kingovchouffe/Mini-DSP/Test board/Test board.pdf

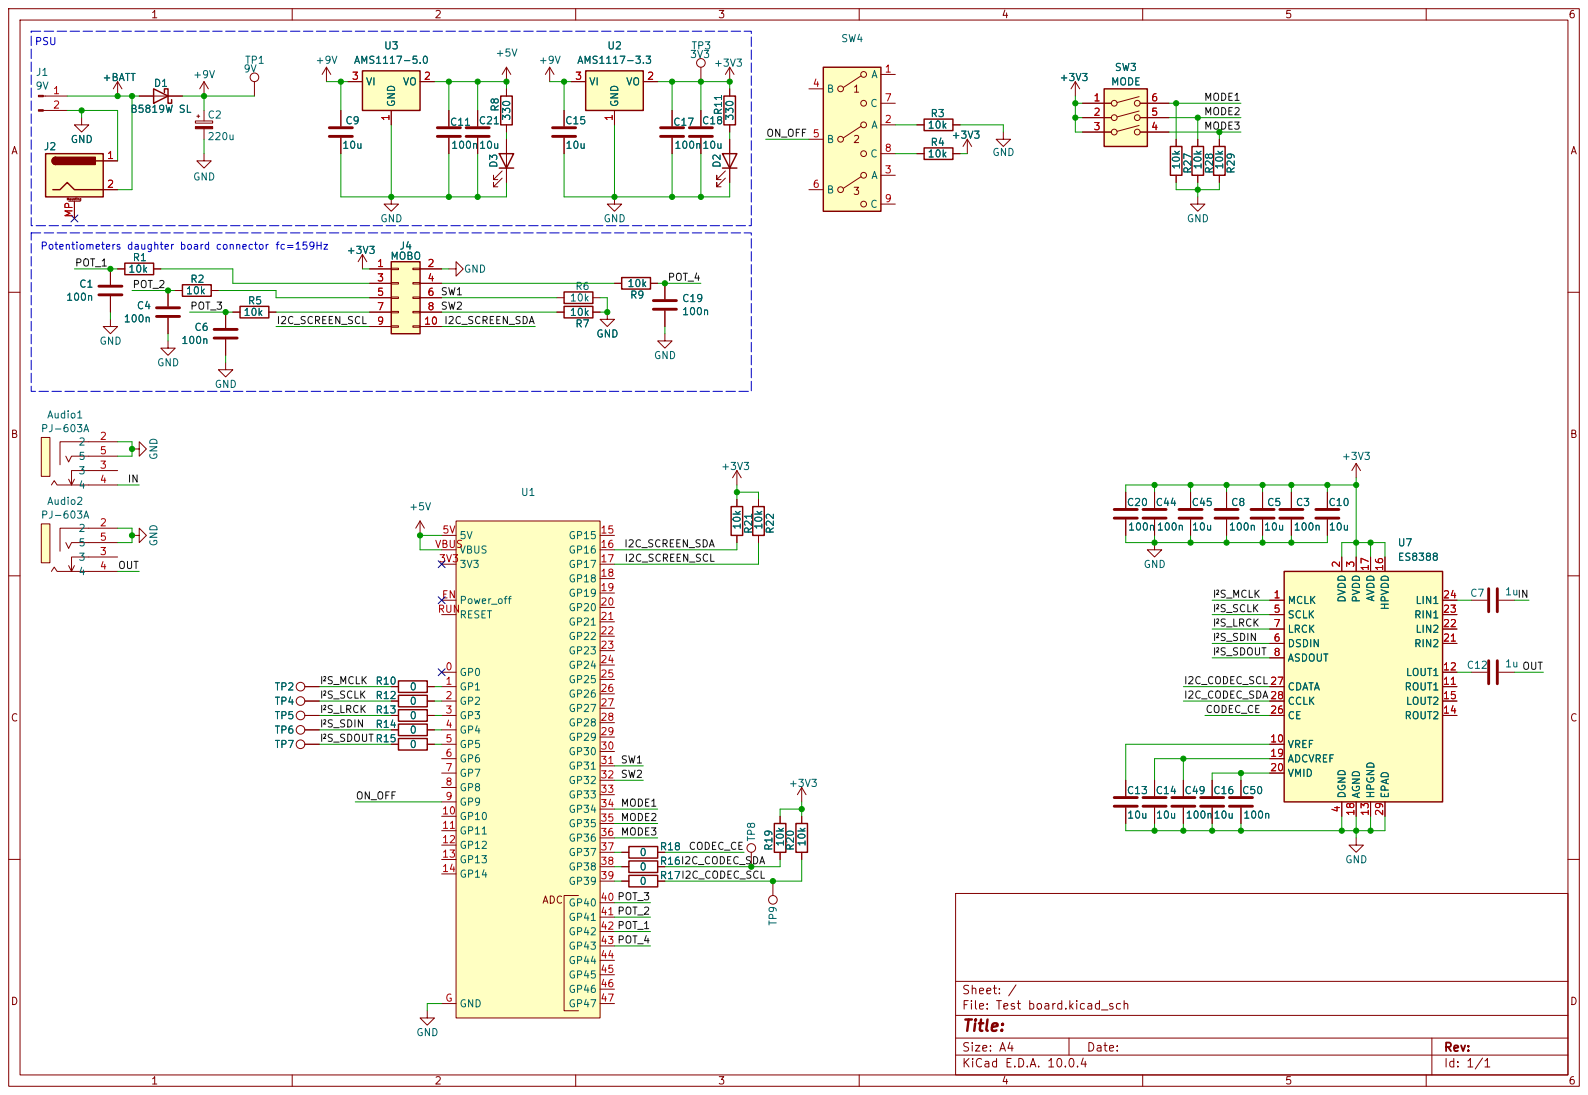
[picture p1: page 1]

Size: A4 | Rev:
KiCad E.D.A. 10.0.4 | Id: 1/1
