kingovchouffe/Mini-DSP/HW/raspi-uhat-codec/raspi-uhat-codec.kicad_pcb

## KiCad design HW/raspi-uhat-codec/raspi-uhat-codec.kicad_pcb (2026-11-07)

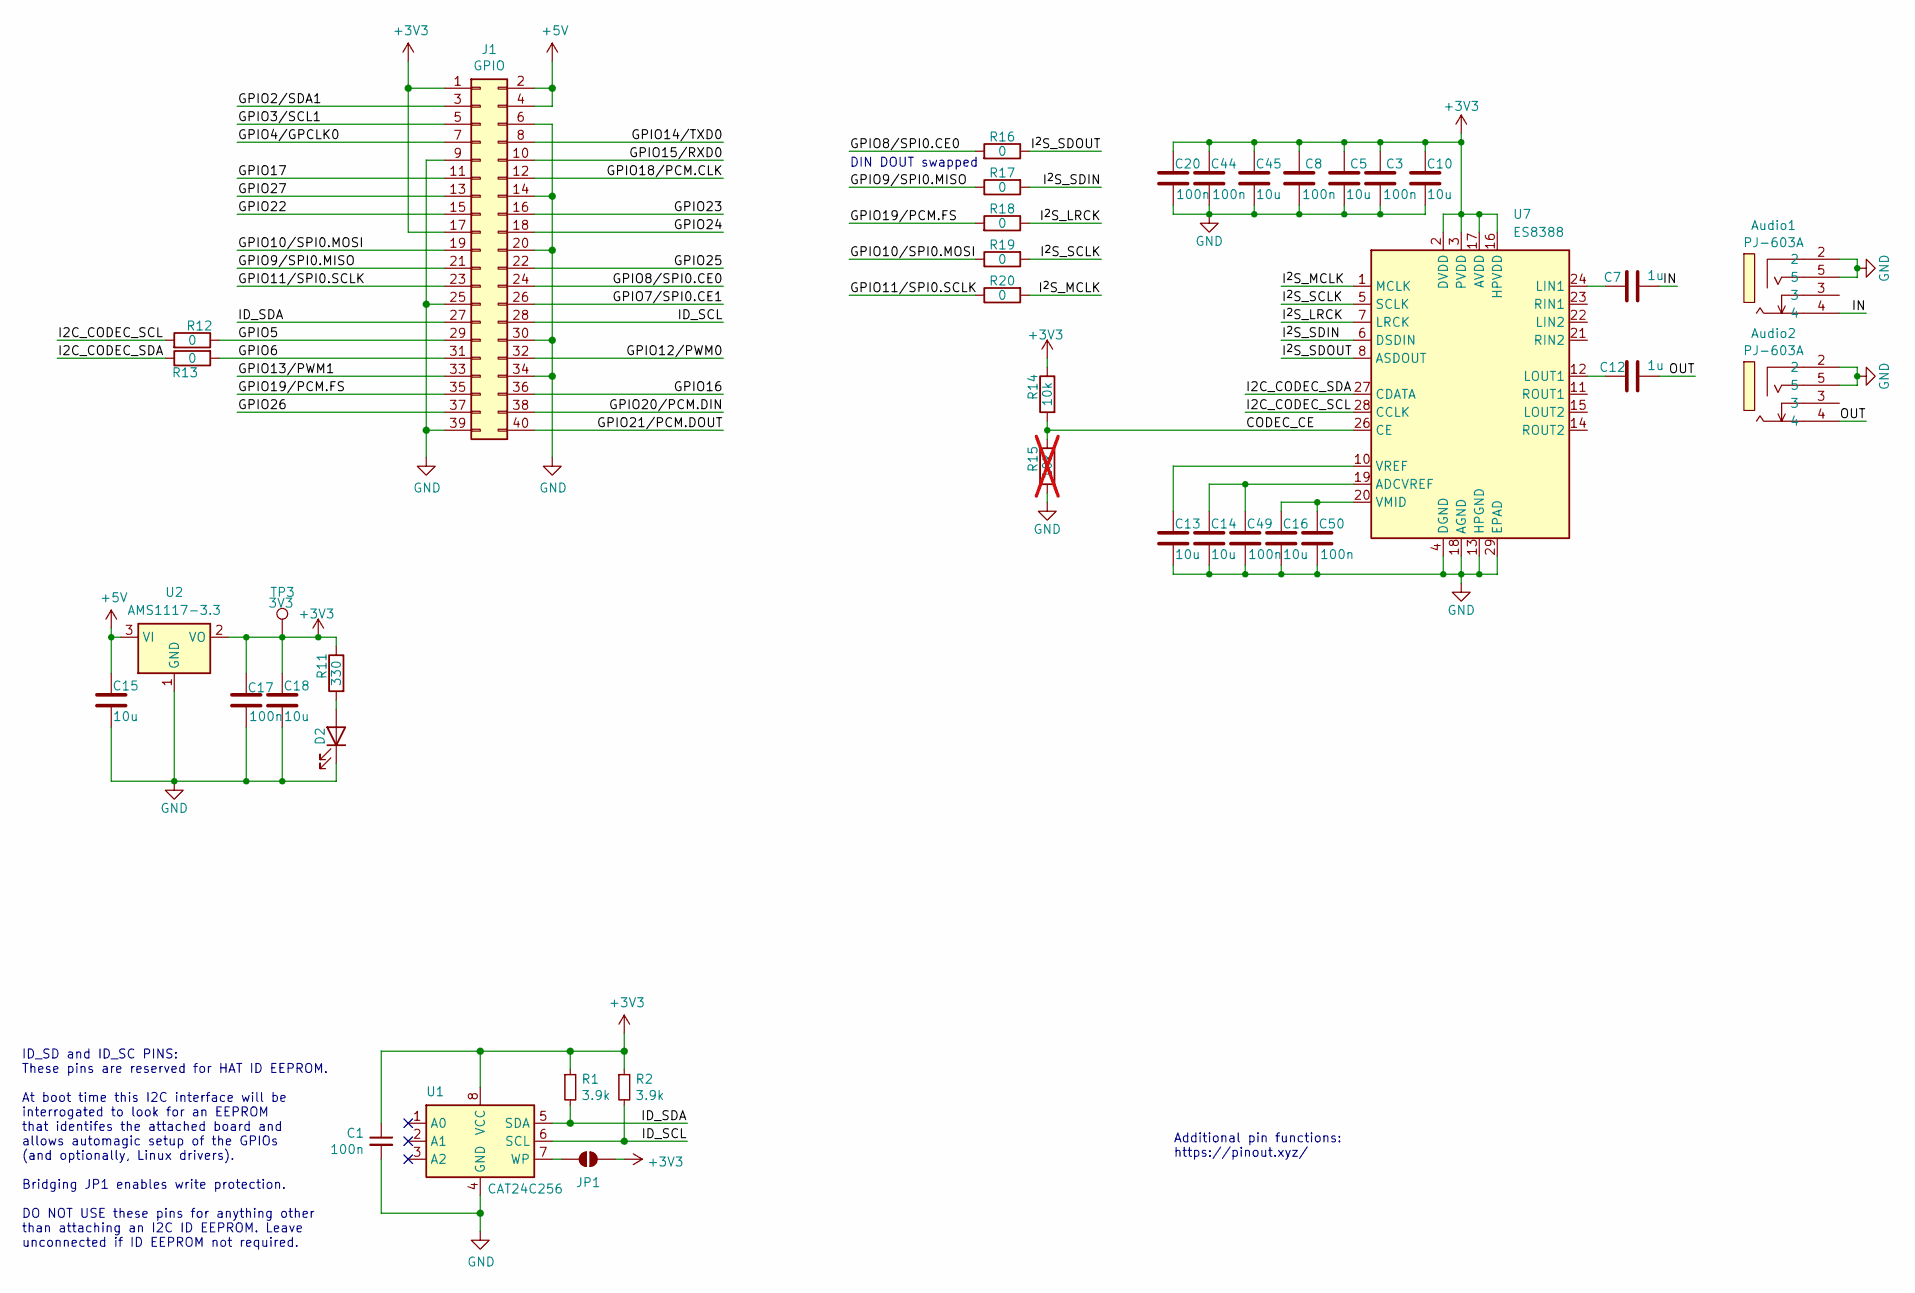
[picture p2: schematic raspi-uhat-codec.kicad_sch]

Parts:
Audio1, Audio2: PJ-603A; AUDIO-TH_PJ-603A_1; LCSC Part C309273
C1, C3, C8, C17, C20, C44, C49, C50: 100n; C_0603_1608Metric
C5, C10, C13, C14, C15, C16, C18, C45: 10u; C_0603_1608Metric
C7, C12: 1u; C_0805_2012Metric
D2: CTL1; LED_0805_2012Metric
J1: GPIO; PinSocket_2x20_P2.54mm_Vertical
JP1: ID_WP; SolderJumper-2_P1.3mm_Open_TrianglePad1.0x1.5mm
R1, R2: 3.9k; R_0603_1608Metric
R11: 330; R_0603_1608Metric
R12, R13, R16, R17, R18, R19, R20: 0; R_0603_1608Metric
R14: 10k; R_0603_1608Metric
R15: 10k; R_0603_1608Metric; not fitted
TP3: 3V3; TestPoint_Pad_D1.0mm
U1: CAT24C256; SOIC-8_3.9x4.9mm_P1.27mm
U2: AMS1117-3.3; SOT-223-3_TabPin2
U7: ES8388; QFN-28-1EP_4x4mm_P0.45mm_EP2.6x2.6mm

Connections:
+3V3: C1.1, C3.1, C5.1, C8.1, C10.1, C17.1, C18.1, C20.1, C44.1, C45.1, J1.1, J1.17, JP1.2 (B), R1.1, R2.1, R11.1, R14.1, TP3.1 (1_1), U1.8 (VCC), U2.2 (VO), U7.2 (DVDD), U7.3 (PVDD), U7.16 (HPVDD), U7.17 (AVDD)
+5V: C15.1, J1.2, J1.4, U2.3 (VI)
/CODEC_CE: R14.2, R15.1, U7.26 (CE)
/GPIO2/SDA1: J1.3
/GPIO3/SCL1: J1.5
/GPIO4/GPCLK0: J1.7
/GPIO5: J1.29, R12.1
/GPIO6: J1.31, R13.2
/GPIO7/SPI0.CE1: J1.26
/GPIO8/SPI0.CE0: J1.24, R16.2
/GPIO9/SPI0.MISO: J1.21, R17.1
/GPIO10/SPI0.MOSI: J1.19, R19.1
/GPIO11/SPI0.SCLK: J1.23, R20.1
/GPIO12/PWM0: J1.32
/GPIO13/PWM1: J1.33
/GPIO14/TXD0: J1.8
/GPIO15/RXD0: J1.10
/GPIO16: J1.36
/GPIO17: J1.11
/GPIO18/PCM.CLK: J1.12
/GPIO19/PCM.FS: J1.35, R18.2
/GPIO20/PCM.DIN: J1.38
/GPIO21/PCM.DOUT: J1.40
/GPIO22: J1.15
/GPIO23: J1.16
/GPIO24: J1.18
/GPIO25: J1.22
/GPIO26: J1.37
/GPIO27: J1.13
/I2C_CODEC_SCL: R12.2, U7.28 (CCLK)
/I2C_CODEC_SDA: R13.1, U7.27 (CDATA)
/ID_SCL: J1.28, R2.2, U1.6 (SCL)
/ID_SDA: J1.27, R1.2, U1.5 (SDA)
/IN: Audio1.4, C7.2
/I^{2}S_LRCK: R18.1, U7.7 (LRCK)
/I^{2}S_MCLK: R20.2, U7.1 (MCLK)
/I^{2}S_SCLK: R19.2, U7.5 (SCLK)
/I^{2}S_SDIN: R17.2, U7.6 (DSDIN)
/I^{2}S_SDOUT: R16.1, U7.8 (ASDOUT)
/OUT: Audio2.4, C12.2
GND: Audio1.2, Audio1.5, Audio2.2, Audio2.5, C1.2, C3.2, C5.2, C8.2, C10.2, C13.2, C14.2, C15.2, C16.2, C17.2, C18.2, C20.2, C44.2, C45.2, C49.2, C50.2, D2.1 (K), J1.6, J1.9, J1.14, J1.20, J1.25, J1.30, J1.34, J1.39, R15.2, U1.4 (GND), U2.1 (GND), U7.4 (DGND), U7.13 (HPGND), U7.18 (AGND), U7.29 (EPAD)
unnamed: D2.2 (A), R11.2
unnamed: JP1.1 (A), U1.7 (WP)
unnamed: C14.1, C49.1, U7.19 (ADCVREF)
unnamed: C7.1, U7.24 (LIN1)
unnamed: C12.1, U7.12 (LOUT1)
unnamed: C16.1, C50.1, U7.20 (VMID)
unnamed: C13.1, U7.10 (VREF)

Notes on the sheet:
ID_SD and ID_SC PINS: These pins are reserved for HAT ID EEPROM. At boot time this I2C interface will be interrogated to look for an EEPROM that identifes the attached board and allows automagic setup of the GPIOs (and optionally, Linux drivers). Bridging JP1 enables write protection. DO NOT USE th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
DIN DOUT swapped
Additional pin functions: https://pinout.xyz/

Board: 2 copper layers, 43 parts (1 on the bottom side), 29 nets, no tracks yet.

Other parts of the board:
MH1, MH2, MH3, MH4: MountingHole_2.7mm_M2.5
