kingovchouffe/Mini-DSP/HW/Main/Mini-DSP.kicad_pcb

## KiCad design HW/Main/Mini-DSP.kicad_pcb (2026-11-07)

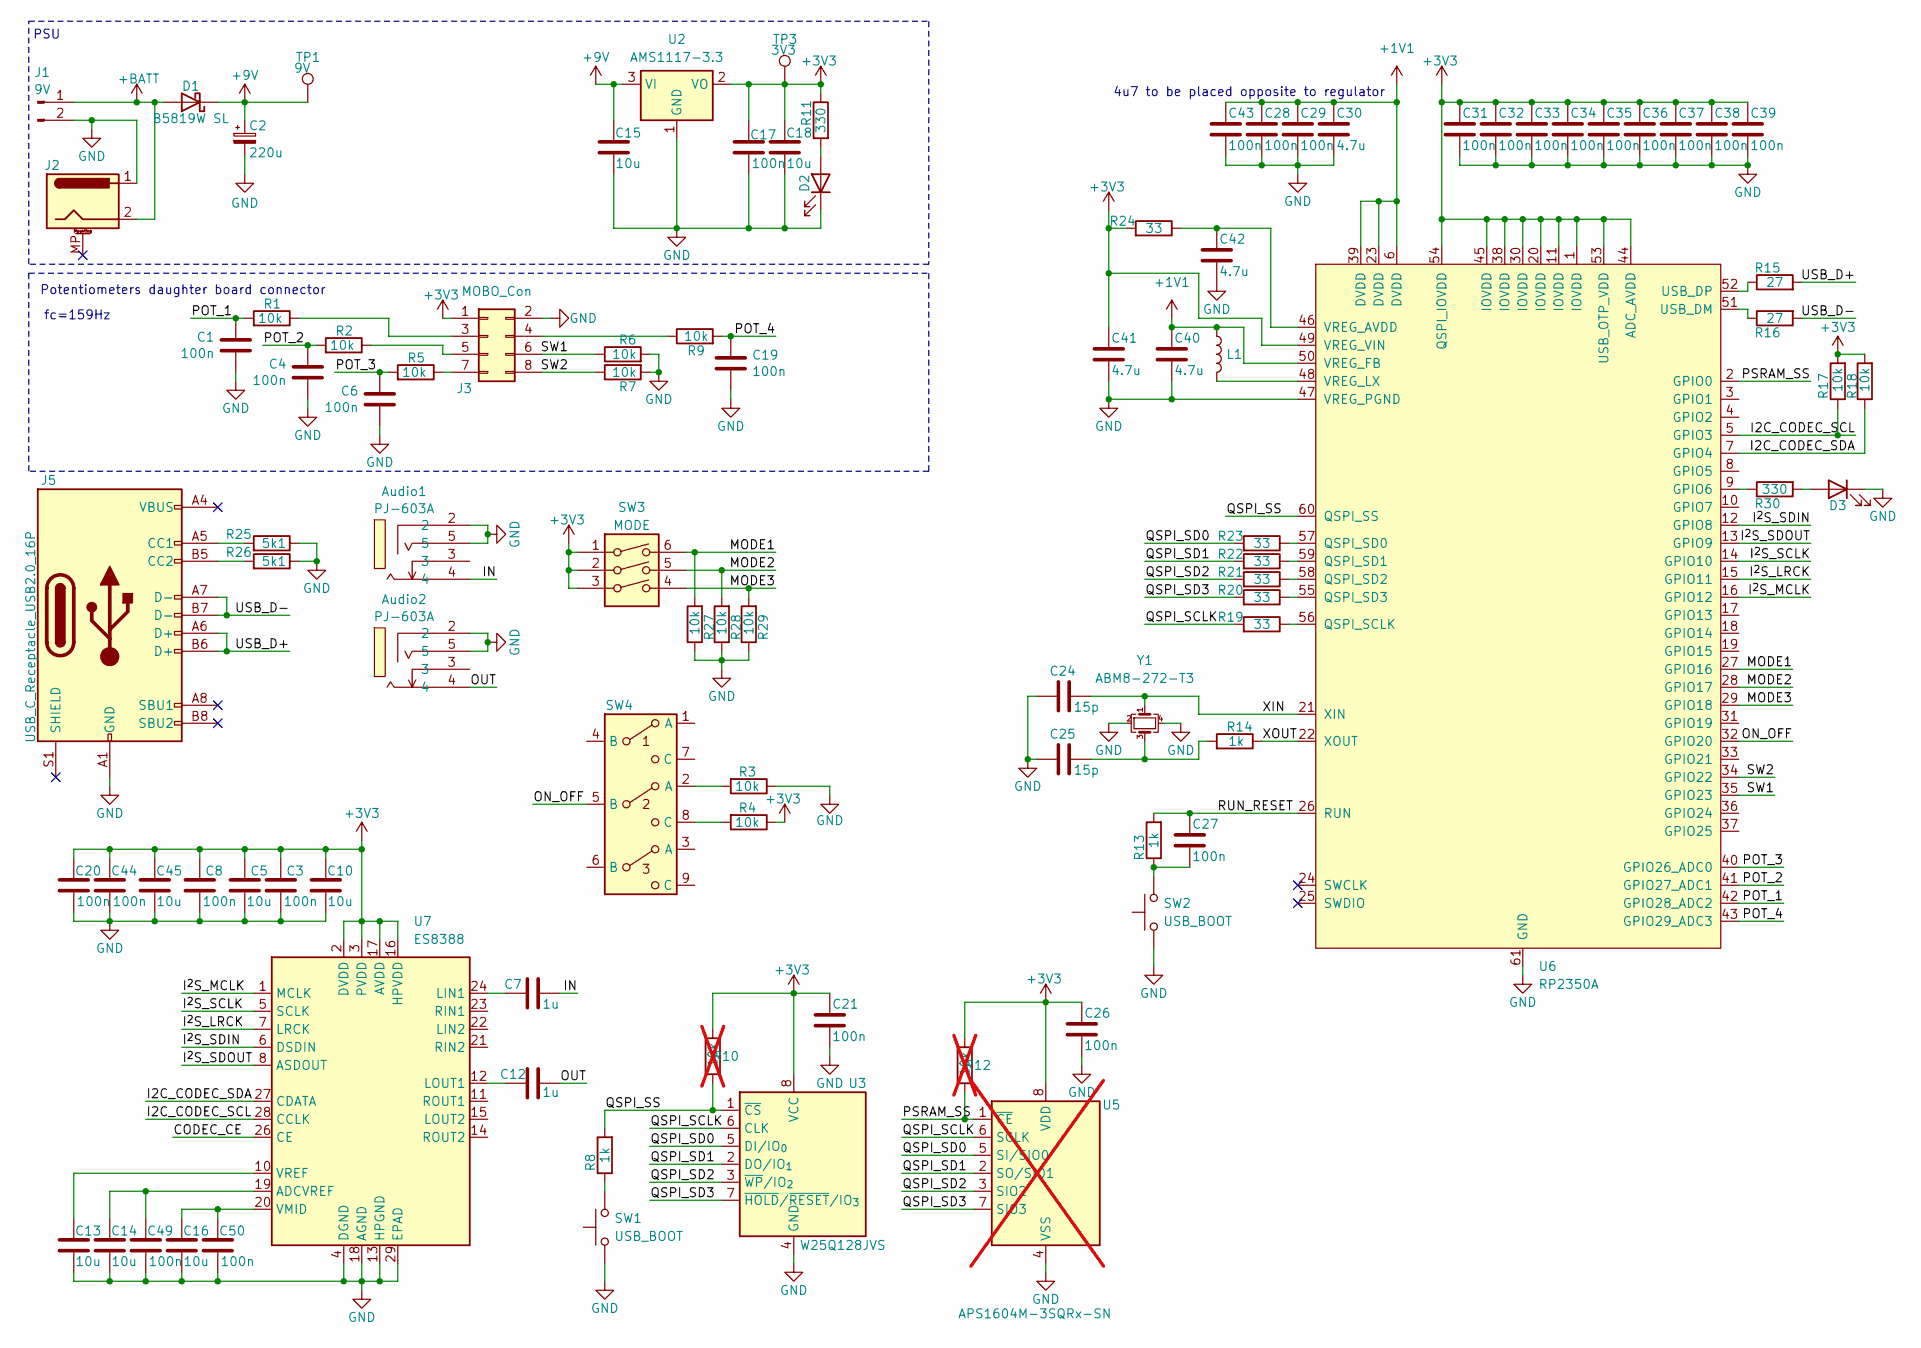
[picture p3: schematic Mini-DSP.kicad_sch]

Parts:
Audio1, Audio2: PJ-603A; AUDIO-TH_PJ-603A_1; LCSC Part C309273
C1, C3, C4, C6, C8, C17, C19, C20, C21, C26, C27, C28, C29, C31, C32, C33, C34, C35, C36, C37, C38, C39, C43, C44, C49, C50: 100n; C_0402_1005Metric
C2: 220u; CP_Elec_6.3x7.7
C5, C10, C13, C14, C15, C16, C18, C45: 10u; C_0603_1608Metric
C7, C12: 1u; C_0805_2012Metric
C24, C25: 15p; C_0402_1005Metric
C30, C40, C41, C42: 4.7u; C_0402_1005Metric
D1: B5819W SL; D_SOD-323; JLCPCB Part C8598
D2, D3: CTL1; LED_0603_1608Metric
J1: 9V; PinSocket_1x02_P2.54mm_Vertical
J2: Barrel_Jack_MountingPin; BarrelJack_Horizontal
J3: MOBO_Con; PinSocket_2x04_P2.54mm_Vertical
J5: USB_C_Receptacle_USB2.0_16P; USB_C_Receptacle_HCTL_HC-TYPE-C-16P-01A
L1: AOTA-B201610S3R3-101-T; L_Murata_DFE201610P
R1, R2, R3, R4, R5, R6, R7, R9, R17, R18, R27, R28, R29: 10k; R_0402_1005Metric
R8, R13, R14: 1k; R_0402_1005Metric
R10, R12: 10k; R_0402_1005Metric; not fitted
R11, R30: 330; R_0402_1005Metric
R15, R16: 27; R_0402_1005Metric
R19, R20, R21, R22, R23, R24: 33; R_0402_1005Metric
R25, R26: 5k1; R_0402_1005Metric
SW1, SW2: USB_BOOT; SW_SPST_TS-1088-xR020
SW3: MODE; SW_DIP_SPSTx03_Slide_KingTek_DSHP03TS_W7.62mm_P1.27mm
SW4: 3PDT_LED
TP1: 9V; TestPoint_Pad_D1.0mm
TP3: 3V3; TestPoint_Pad_D1.0mm
U2: AMS1117-3.3; SOT-223-3_TabPin2
U3: W25Q128JVS; SOIC-8_5.3x5.3mm_P1.27mm
U5: APS1604M-3SQRx-SN; SOIC-8_3.9x4.9mm_P1.27mm; not fitted
U6: RP2350A; QFN-60-1EP_7x7mm_P0.4mm_EP3.4x3.4mm_ThermalVias
U7: ES8388; QFN-28-1EP_4x4mm_P0.45mm_EP2.6x2.6mm
Y1: ABM8-272-T3; Crystal_SMD_3225-4Pin_3.2x2.5mm

Connections:
+1V1: C28.1, C29.1, C30.1, C40.1, C43.1, L1.1, U6.6 (DVDD), U6.23 (DVDD), U6.39 (DVDD), U6.50 (VREG_FB)
+3V3: C3.1, C5.1, C8.1, C10.1, C17.1, C18.1, C20.1, C21.1, C26.1, C31.1, C32.1, C33.1, C34.1, C35.1, C36.1, C37.1, C38.1, C39.1, C41.1, C44.1, C45.1, J3.1, R4.1, R10.2, R11.1, R12.2, R17.2, R18.2, R24.2, SW3.1, SW3.2, SW3.3, TP3.1 (1_1), U2.2 (VO), U3.8 (VCC), U5.8 (VDD), U6.1 (IOVDD), U6.11 (IOVDD), U6.20 (IOVDD), U6.30 (IOVDD), U6.38 (IOVDD), U6.44 (ADC_AVDD), U6.45 (IOVDD), U6.49 (VREG_VIN), U6.53 (USB_OTP_VDD), U6.54 (QSPI_IOVDD), U7.2 (DVDD), U7.3 (PVDD), U7.16 (HPVDD), U7.17 (AVDD)
+9V: C2.1, C15.1, D1.1 (K), TP1.1 (1_1), U2.3 (VI)
+BATT: D1.2 (A), J1.1, J2.2
/CODEC_CE: U7.26 (CE)
/I2C_CODEC_SCL: R17.1, U6.5 (GPIO3), U7.28 (CCLK)
/I2C_CODEC_SDA: R18.1, U6.7 (GPIO4), U7.27 (CDATA)
/IN: Audio1.4, C7.2
/I^{2}S_LRCK: U6.15 (GPIO11), U7.7 (LRCK)
/I^{2}S_MCLK: U6.16 (GPIO12), U7.1 (MCLK)
/I^{2}S_SCLK: U6.14 (GPIO10), U7.5 (SCLK)
/I^{2}S_SDIN: U6.12 (GPIO8), U7.6 (DSDIN)
/I^{2}S_SDOUT: U6.13 (GPIO9), U7.8 (ASDOUT)
/MODE1: R27.2, SW3.6, U6.27 (GPIO16)
/MODE2: R28.2, SW3.5, U6.28 (GPIO17)
/MODE3: R29.2, SW3.4, U6.29 (GPIO18)
/ON_OFF: SW4.5 (B), U6.32 (GPIO20)
/OUT: Audio2.4, C12.2
/POT_1: C1.1, R1.2, U6.42 (GPIO28_ADC2)
/POT_2: C4.1, R2.2, U6.41 (GPIO27_ADC1)
/POT_3: C6.1, R5.2, U6.40 (GPIO26_ADC0)
/POT_4: C19.1, R9.2, U6.43 (GPIO29_ADC3)
/PSRAM_SS: R12.1, U5.1 (~CE), U6.2 (GPIO0)
/QSPI_SCLK: R19.2, U3.6 (CLK), U5.6 (SCLK)
/QSPI_SD0: R23.2, U3.5 (DI/IO_{0}), U5.5 (SI/SIO0)
/QSPI_SD1: R22.2, U3.2 (DO/IO_{1}), U5.2 (SO/SIO1)
/QSPI_SD2: R21.2, U3.3 (~WP/IO_{2}), U5.3 (SIO2)
/QSPI_SD3: R20.2, U3.7 (~HOLD/~RESET/IO_{3}), U5.7 (SIO3)
/QSPI_SS: R8.2, R10.1, U3.1 (~CS), U6.60 (QSPI_SS)
/RUN_RESET: C27.1, R13.2, U6.26 (RUN)
/SW1: J3.6, R6.1, U6.35 (GPIO23)
/SW2: J3.8, R7.1, U6.34 (GPIO22)
/USB_D+: J5.A6 (D+), J5.B6 (D+), R15.2
/USB_D-: J5.A7 (D-), J5.B7 (D-), R16.2
/XIN: C24.2, U6.21 (XIN), Y1.1
/XOUT: R14.1, U6.22 (XOUT)
GND: Audio1.2, Audio1.5, Audio2.2, Audio2.5, C1.2, C2.2, C3.2, C4.2, C5.2, C6.2, C8.2, C10.2, C13.2, C14.2, C15.2, C16.2, C17.2, C18.2, C19.2, C20.2, C21.2, C24.1, C25.1, C26.2, C28.2, C29.2, C30.2, C31.2, C32.2, C33.2, C34.2, C35.2, C36.2, C37.2, C38.2, C39.2, C40.2, C41.2, C42.2, C43.2, C44.2, C45.2, C49.2, C50.2, D2.1 (K), D3.1 (K), J1.2, J2.1, J3.2, J5.A1 (GND), J5.A12 (GND), J5.B1 (GND), J5.B12 (GND), R3.1, R6.2, R7.2, R25.1, R26.1, R27.1, R28.1, R29.1, SW1.1, SW2.1, U2.1 (GND), U3.4 (GND), U5.4 (VSS), U6.47 (VREG_PGND), U6.61 (GND), U7.4 (DGND), U7.13 (HPGND), U7.18 (AGND), U7.29 (EPAD), Y1.2, Y1.4
unnamed: C25.2, R14.2, Y1.3
unnamed: C27.2, R13.1, SW2.2
unnamed: D2.2 (A), R11.2
unnamed: D3.2 (A), R30.2
unnamed: J3.3, R1.1
unnamed: J3.4, R9.1
unnamed: J3.5, R2.1
unnamed: J3.7, R5.1
unnamed: J5.A5 (CC1), R25.2
unnamed: J5.B5 (CC2), R26.2
unnamed: R3.2, SW4.2 (A)
unnamed: R4.2, SW4.8 (C)
unnamed: R8.1, SW1.2
unnamed: R30.1, U6.9 (GPIO6)
unnamed: R19.1, U6.56 (QSPI_SCLK)
unnamed: R23.1, U6.57 (QSPI_SD0)
unnamed: R22.1, U6.59 (QSPI_SD1)
unnamed: R21.1, U6.58 (QSPI_SD2)
unnamed: R20.1, U6.55 (QSPI_SD3)
unnamed: R16.1, U6.51 (USB_DM)
unnamed: R15.1, U6.52 (USB_DP)
unnamed: C42.1, R24.1, U6.46 (VREG_AVDD)
unnamed: L1.2, U6.48 (VREG_LX)
unnamed: C14.1, C49.1, U7.19 (ADCVREF)
unnamed: C7.1, U7.24 (LIN1)
unnamed: C12.1, U7.12 (LOUT1)
unnamed: C16.1, C50.1, U7.20 (VMID)
unnamed: C13.1, U7.10 (VREF)

Notes on the sheet:
4u7 to be placed opposite to regulator
PSU
fc=159Hz
Potentiometers daughter board connector

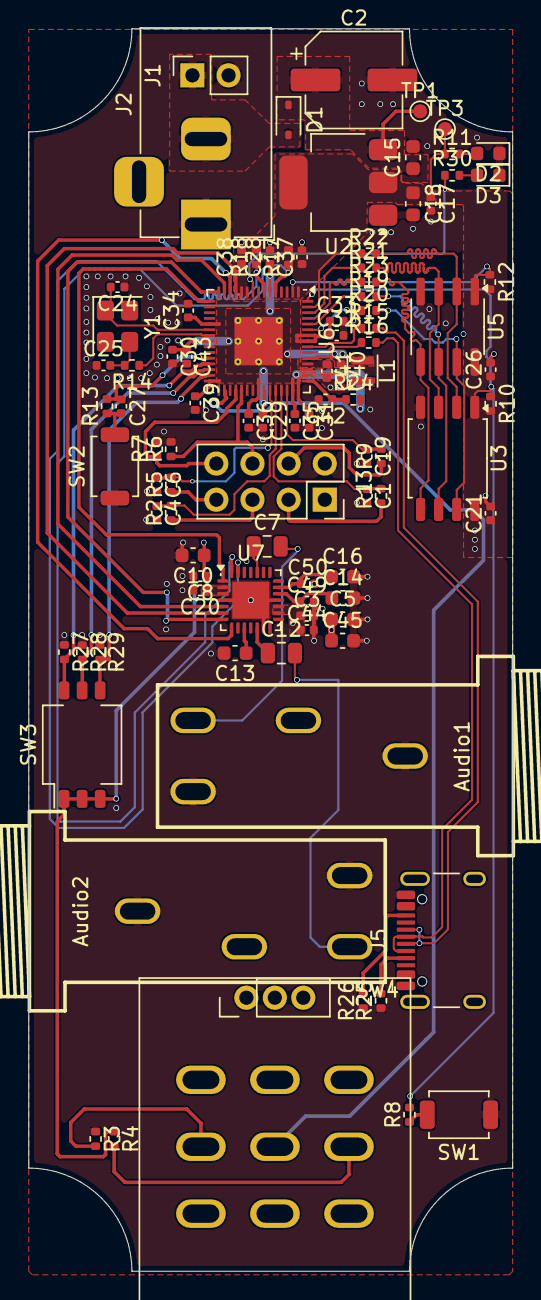
[picture p4: board Mini-DSP.kicad_pcb from above]

Board: 4 copper layers, 34.0 x 87.3 mm, 95 parts (0 on the bottom side), 64 nets.
