kingovchouffe/Mini-DSP/HW/Test board/Test board.kicad_pcb

## KiCad design HW/Test board/Test board.kicad_pcb (2026-11-07)

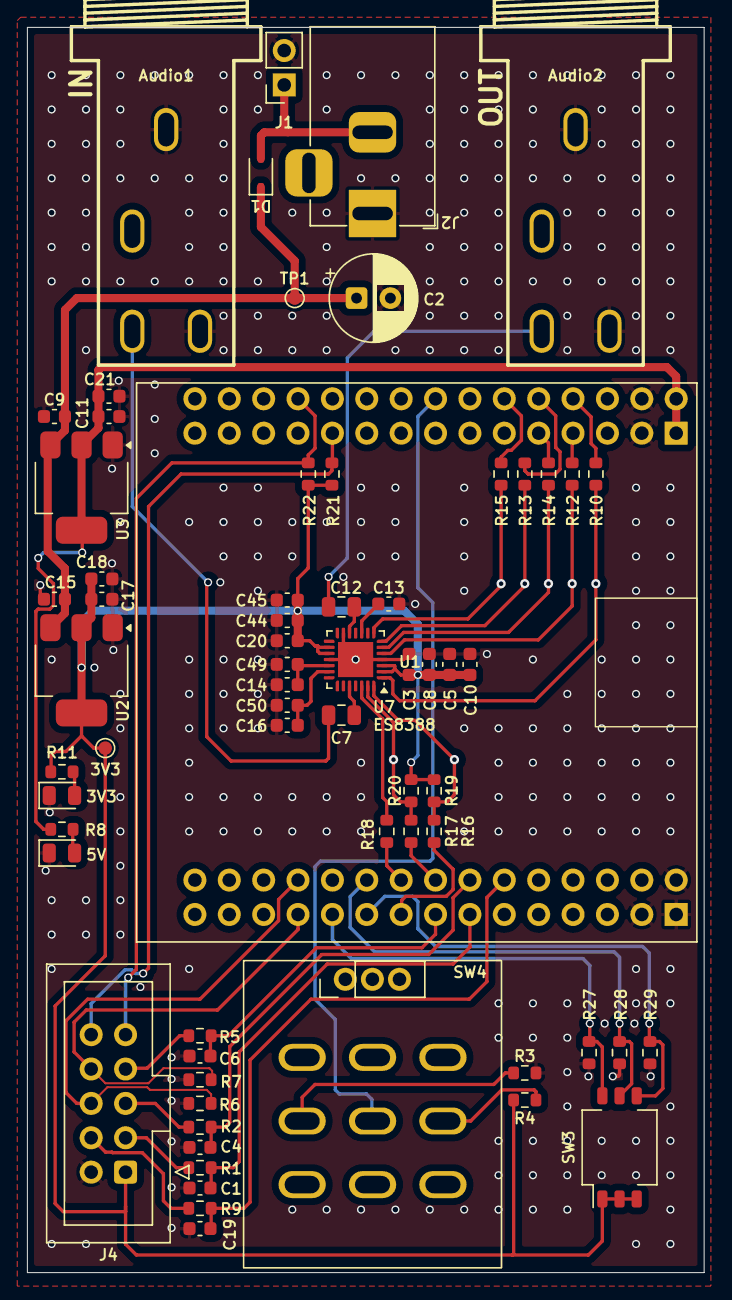
[picture p5: board Test board.kicad_pcb from above]

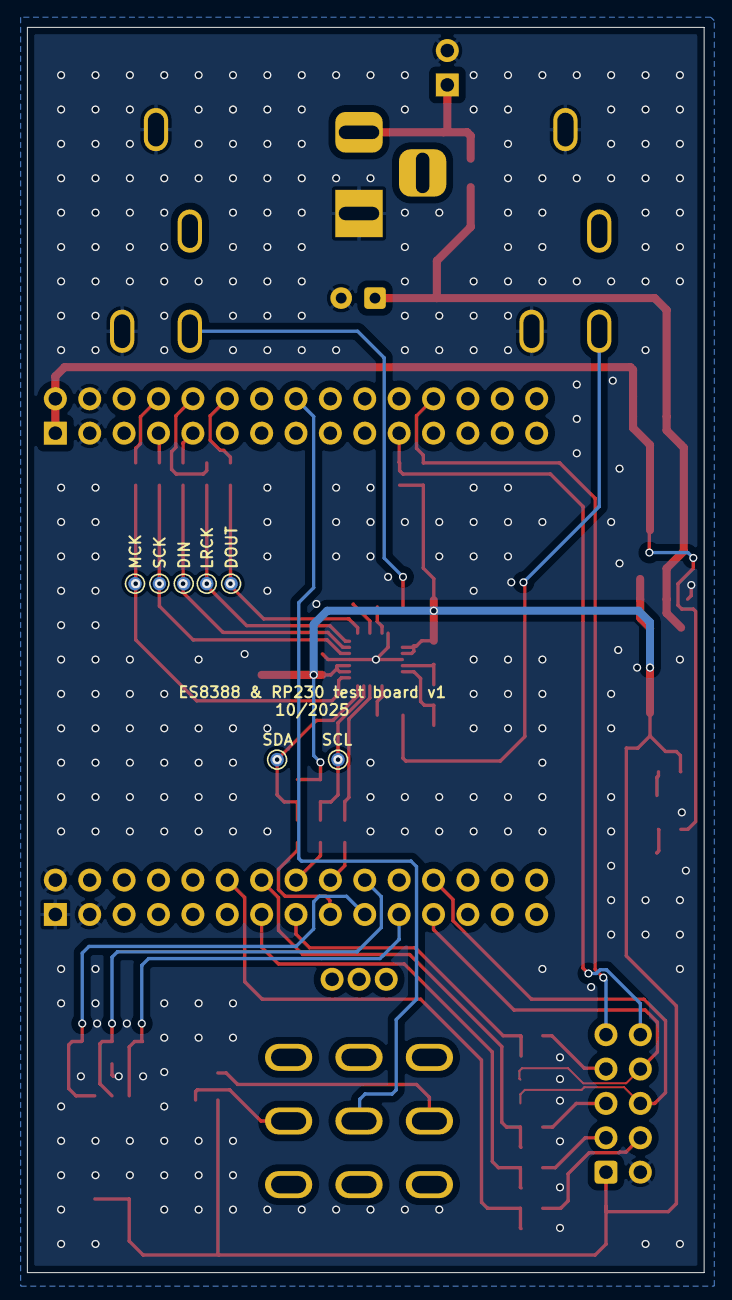
[picture p6: board Test board.kicad_pcb from below]

Board: 2 copper layers, 50.0 x 92.0 mm, 73 parts (7 on the bottom side), 48 nets.

Parts:
Audio1, Audio2: PJ-603A; AUDIO-TH_PJ-603A_1
C1, C3, C4, C6, C8, C11, C17, C19, C20, C44, C49, C50: 100n; C_0603_1608Metric
C2: 220u; CP_Radial_D6.3mm_P2.50mm
C5, C9, C10, C13, C14, C15, C16, C18, C21, C45: 10u; C_0603_1608Metric
C7, C12: 1u; C_0805_2012Metric
D1: B5819W SL; D_SOD-323
D2, D3: CTL1; LED_0805_2012Metric
J1: 9V; PinSocket_1x02_P2.54mm_Vertical
J2: Barrel_Jack_MountingPin; BarrelJack_Horizontal
J4: MOBO; IDC-Header_2x05_P2.54mm_Vertical
R1, R2, R3, R4, R5, R6, R7, R9, R19, R20, R21, R22, R27, R28, R29: 10k; R_0603_1608Metric
R8, R11: 330; R_0603_1608Metric
R10, R12, R13, R14, R15, R16, R17, R18: 0; R_0603_1608Metric
SW3: MODE; SW_DIP_SPSTx03_Slide_KingTek_DSHP03TS_W7.62mm_P1.27mm
SW4: 3PDT_LED
TP1: 9V; TestPoint_Pad_D1.0mm
TP2, TP4, TP5, TP6, TP7, TP8, TP9: TestPoint_Pad_D1.0mm
TP3: 3V3; TestPoint_Pad_D1.0mm
U1: WeAct2550B
U2: AMS1117-3.3; SOT-223-3_TabPin2
U3: AMS1117-5.0; SOT-223-3_TabPin2
U7: ES8388; QFN-28-1EP_4x4mm_P0.45mm_EP2.6x2.6mm

Connections:
+3V3: C3.1, C5.1, C8.1, C10.1, C17.1, C18.1, C20.1, C44.1, C45.1, J4.1, R4.1, R11.1, R19.2, R20.2, R21.2, R22.2, SW3.1, SW3.2, SW3.3, TP3.1, U2.2 (VO), U7.2 (DVDD), U7.3 (PVDD), U7.16 (HPVDD), U7.17 (AVDD)
+5V: C11.1, C21.1, R8.1, U1.5V, U1.VBUS, U3.2 (VO)
+9V: C2.1, C9.1, C15.1, D1.1 (K), TP1.1, U2.3 (VI), U3.3 (VI)
+BATT: D1.2 (A), J1.1, J2.2
/CODEC_CE: R18.1, U7.26 (CE)
/I2C_CODEC_SCL: R17.1, R20.1, TP9.1, U7.27 (CDATA)
/I2C_CODEC_SDA: R16.1, R19.1, TP8.1, U7.28 (CCLK)
/I2C_SCREEN_SCL: J4.9, R22.1, U1.17 (GP17)
/I2C_SCREEN_SDA: J4.10, R21.1, U1.16 (GP16)
/IN: Audio1.4, C7.2
/I^{2}S_LRCK: R13.1, TP5.1, U7.7 (LRCK)
/I^{2}S_MCLK: R10.1, TP2.1, U7.1 (MCLK)
/I^{2}S_SCLK: R12.1, TP4.1, U7.5 (SCLK)
/I^{2}S_SDIN: R14.1, TP6.1, U7.6 (DSDIN)
/I^{2}S_SDOUT: R15.1, TP7.1, U7.8 (ASDOUT)
/MODE1: R27.2, SW3.6, U1.34 (GP34)
/MODE2: R28.2, SW3.5, U1.35 (GP35)
/MODE3: R29.2, SW3.4, U1.36 (GP36)
/ON_OFF: SW4.5 (B), U1.9 (GP9)
/OUT: Audio2.4, C12.2
/POT_1: C1.1, R1.2, U1.42 (GP42)
/POT_2: C4.1, R2.2, U1.41 (GP41)
/POT_3: C6.1, R5.2, U1.40 (GP40)
/POT_4: C19.1, R9.2, U1.43 (GP43)
/SW1: J4.6, R6.1, U1.31 (GP31)
/SW2: J4.8, R7.1, U1.32 (GP32)
GND: Audio1.2, Audio1.5, Audio2.2, Audio2.5, C1.2, C2.2, C3.2, C4.2, C5.2, C6.2, C8.2, C9.2, C10.2, C11.2, C13.2, C14.2, C15.2, C16.2, C17.2, C18.2, C19.2, C20.2, C21.2, C44.2, C45.2, C49.2, C50.2, D2.1 (K), D3.1 (K), J1.2, J2.1, J4.2, R3.1, R6.2, R7.2, R27.1, R28.1, R29.1, U1.G (GND), U2.1 (GND), U3.1 (GND), U7.4 (DGND), U7.13 (HPGND), U7.18 (AGND), U7.29 (EPAD)
unnamed: D2.2 (A), R11.2
unnamed: D3.2 (A), R8.2
unnamed: J4.3, R1.1
unnamed: J4.4, R9.1
unnamed: J4.5, R2.1
unnamed: J4.7, R5.1
unnamed: R3.2, SW4.2 (A)
unnamed: R4.2, SW4.8 (C)
unnamed: R10.2, U1.1 (GP1)
unnamed: R12.2, U1.2 (GP2)
unnamed: R13.2, U1.3 (GP3)
unnamed: R14.2, U1.4 (GP4)
unnamed: R15.2, U1.5 (GP5)
unnamed: R18.2, U1.37 (GP37)
unnamed: R16.2, U1.38 (GP38)
unnamed: R17.2, U1.39 (GP39)
unnamed: C14.1, C49.1, U7.19 (ADCVREF)
unnamed: C7.1, U7.24 (LIN1)
unnamed: C12.1, U7.12 (LOUT1)
unnamed: C16.1, C50.1, U7.20 (VMID)
unnamed: C13.1, U7.10 (VREF)
