kingovchouffe/Mini-DSP/(commit log)

2025-09-21 update schematic and placement
    - missing 3PDT part
    - need to change CS4270 (EoL)
    [Mini-DSP.kicad_pcb, Mini-DSP.kicad_sch]
2025-09-28 test board update
    [Mini-DSP.kicad_pcb, Mini-DSP.kicad_sch, Test board.kicad_pcb, Test board.kicad_sch]
2026-11-03 fixed schematic error in both test board and main board no layout mod
2026-11-03 first loopback and sample effects working
2026-11-07 Add uhat board
